Vassar-Robot-Competition-2018/teamA/notebook/IMG_0_WEEK4.JPG

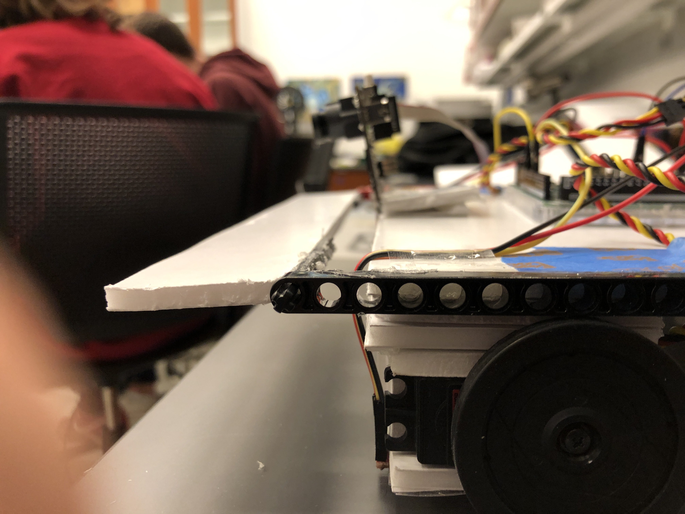
notebook/IMG_0_WEEK4.JPG
