Vassar-Robot-Competition-2018/teamA/notebook/IMG_1_WEEK4.JPG

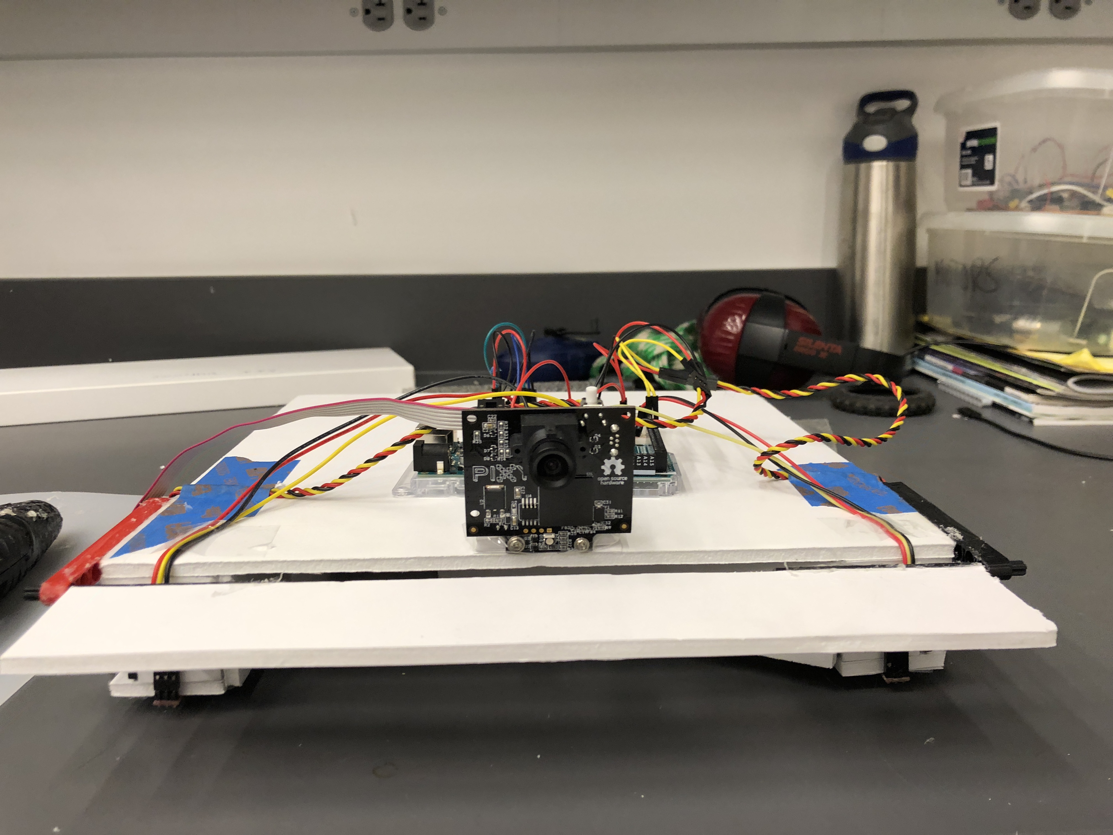
notebook/IMG_1_WEEK4.JPG
