Vassar-Robot-Competition-2018/teamA/notebook/IMG_2WEEK4.JPG

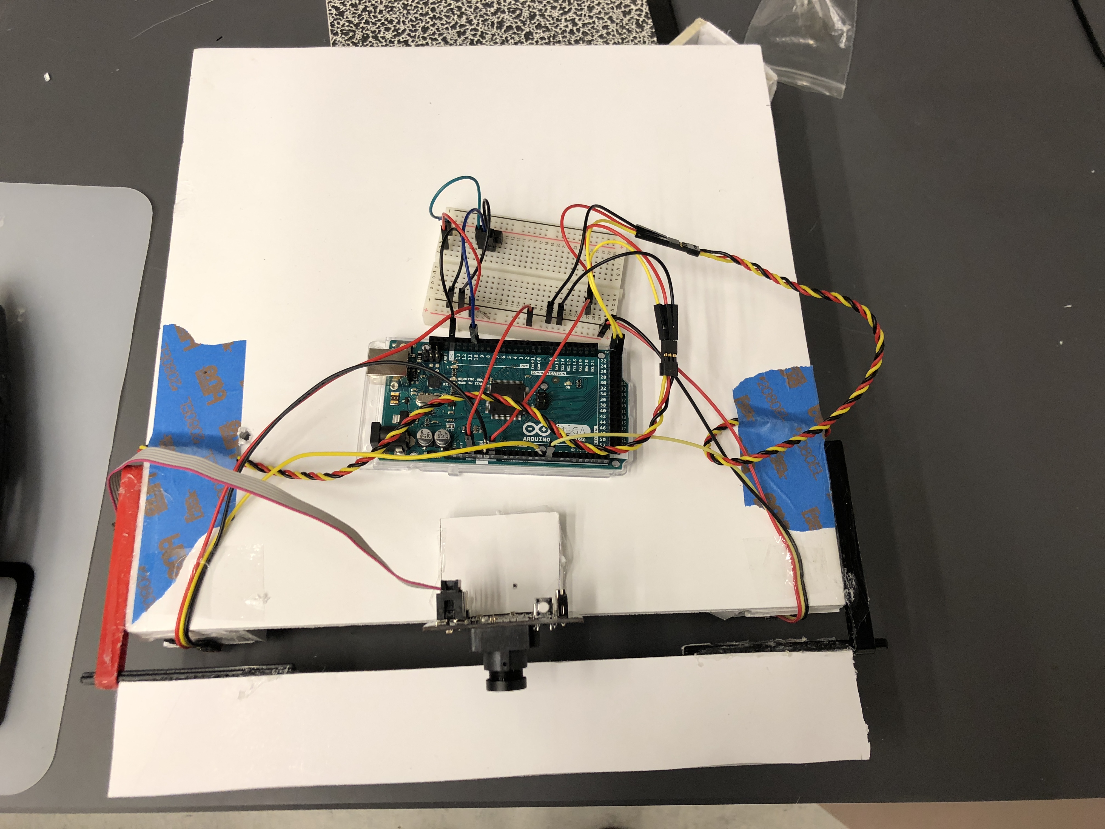
notebook/IMG_2WEEK4.JPG
