Vassar-Robot-Competition-2018/teamA/notebook/IMG_2205.jpg

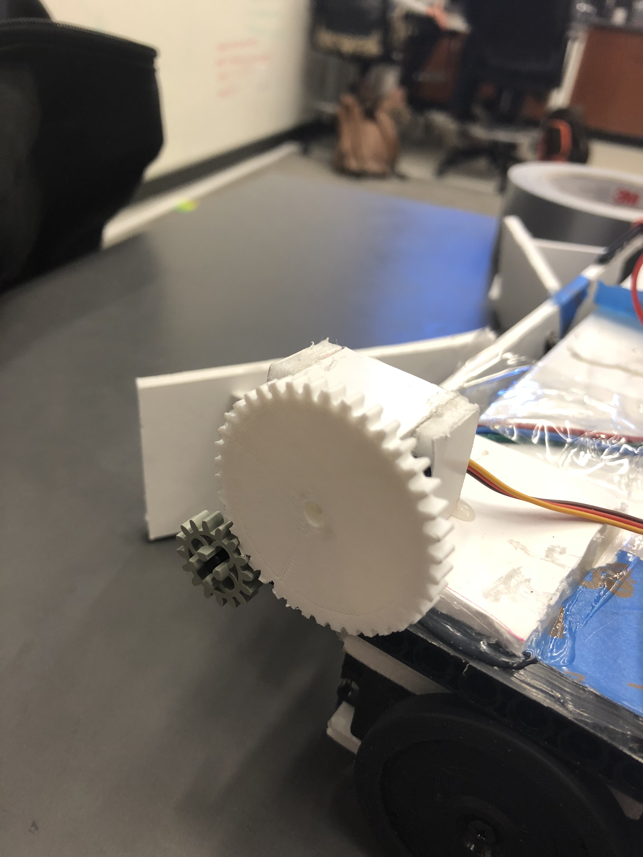
notebook/IMG_2205.jpg
