Vassar-Robot-Competition-2018/teamA/notebook/IMG_2209.jpg

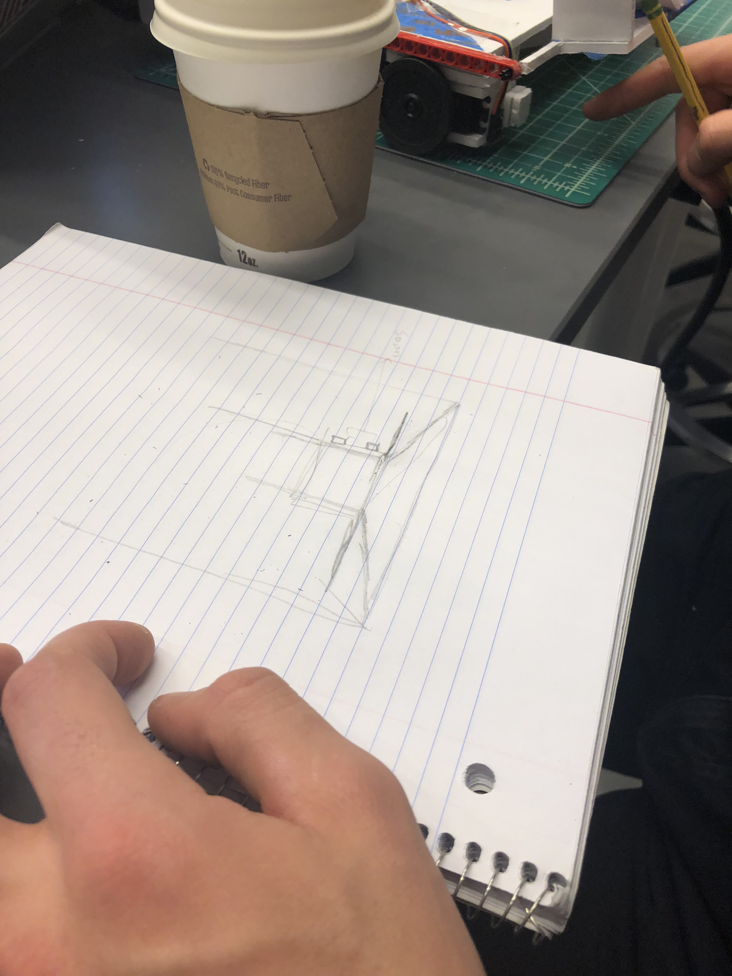
notebook/IMG_2209.jpg
