Vassar-Robot-Competition-2018/teamA/notebook/week-3-1.jpg

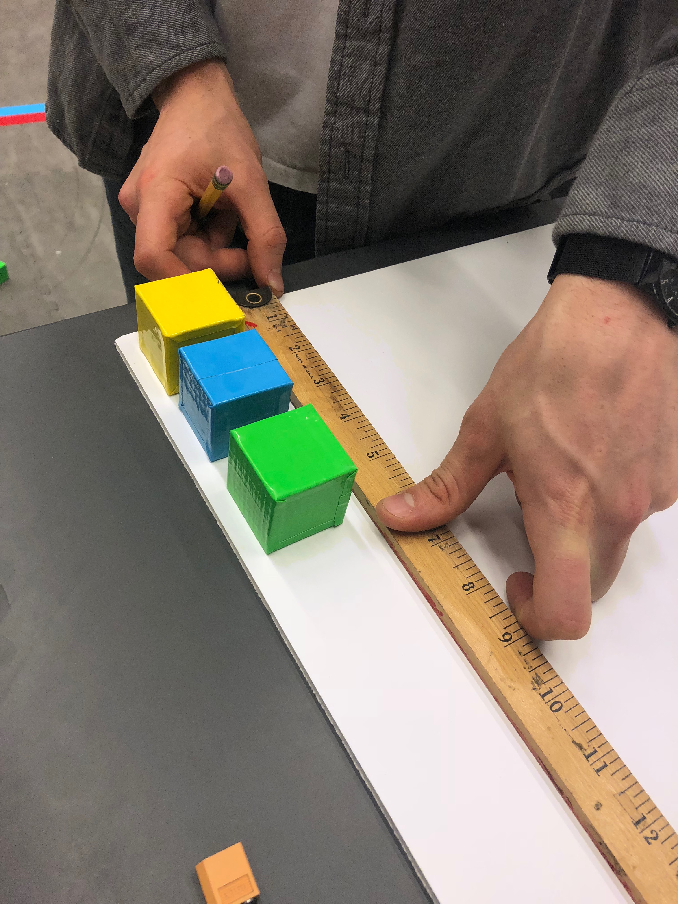
notebook/week-3-1.jpg
