Vassar-Robot-Competition-2018/teamA/notebook/week-3-3.jpg

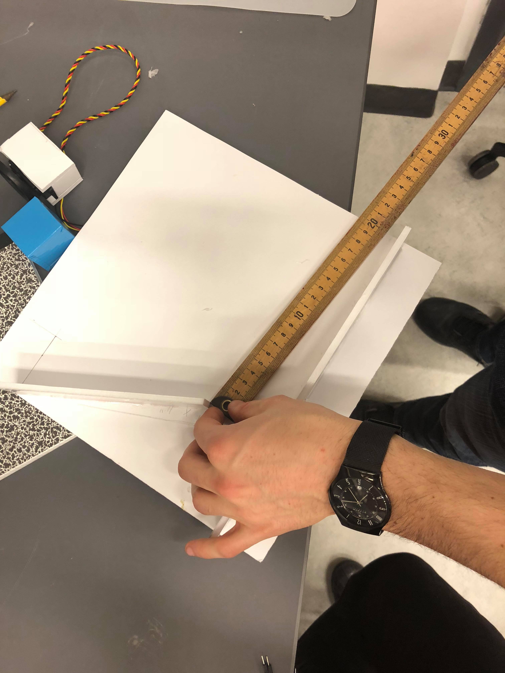
notebook/week-3-3.jpg
