Vassar-Robot-Competition-2018/teamA/notebook/week-3-5.jpg

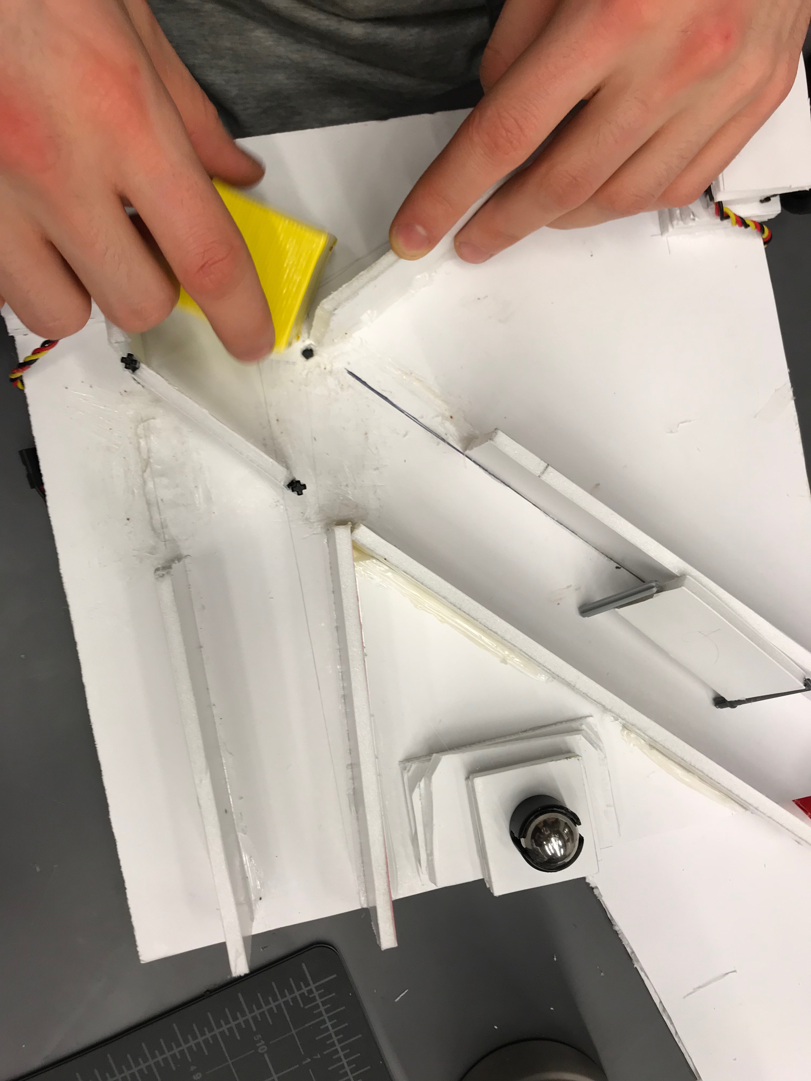
notebook/week-3-5.jpg
