Vassar-Robot-Competition-2018/teamA/notebook/week-3-6.jpg

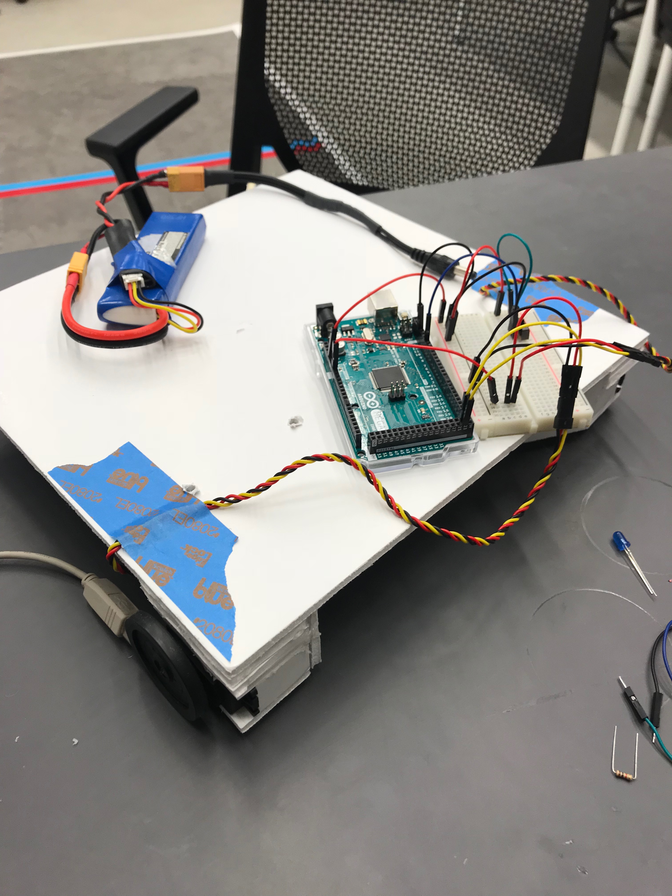
notebook/week-3-6.jpg
