Vassar-Robot-Competition-2018/teamA/notebook/week-5-image1.jpg

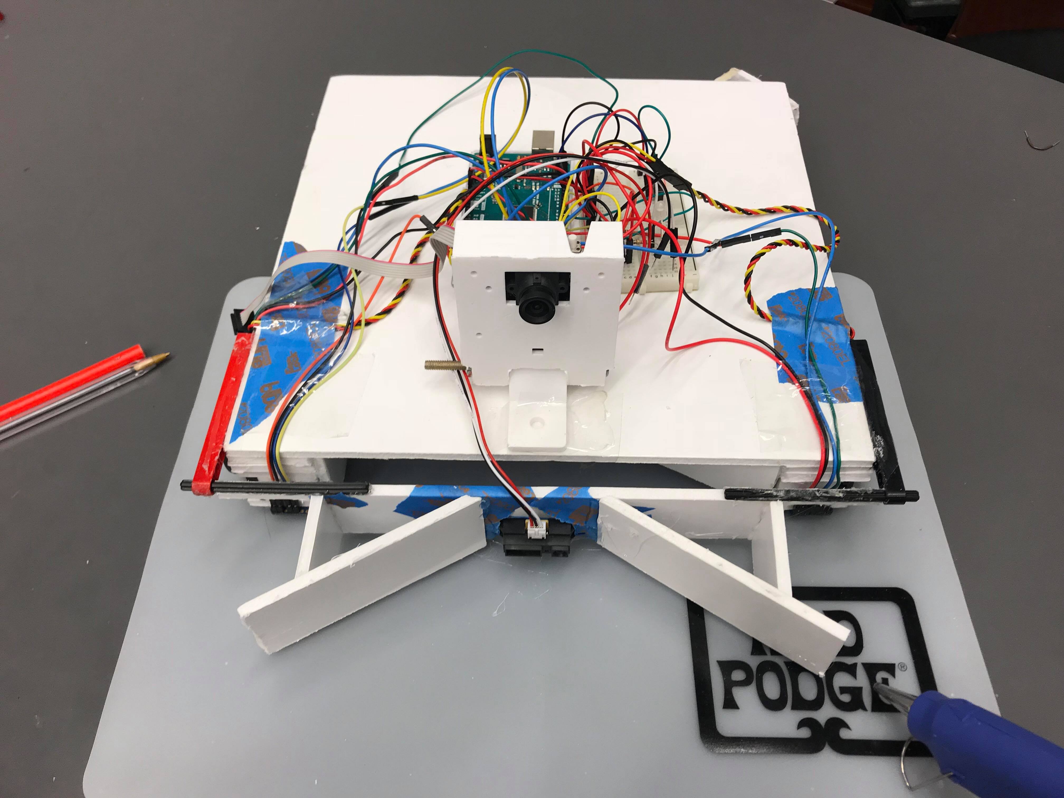
notebook/week-5-image1.jpg
