Vassar-Robot-Competition-2018/teamA/notebook/Gear Rack (3).stl

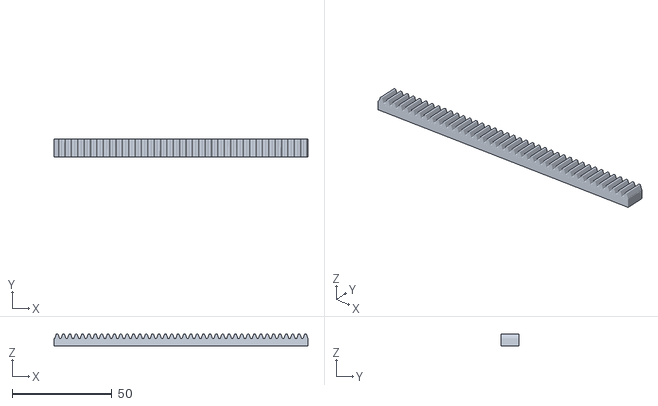
[picture p15: CAD file, 2018-04-03]
notebook/Gear Rack (3).stl
127.0 x 9.00 x 6.12
