Vassar-Robot-Competition-2018/teamA/code/code.ino

// Color sensor module which allows for multiple sensors
// https://github.com/Fire7/Adafruit_TCS34725_SoftI2C
#include <Adafruit_TCS34725softi2c.h>

// Pixy module
#include <SPI.h>
#include <Pixy.h>

// Servo module
#include <Servo.h>

int baud = 9600;

// Debug flag. Set to 1 if we want to print debug info
boolean DEBUG = 1;

// Constants
const int leftFrontServoPin = 8; // Continuous rotation servo for left front wheel
const int rightFrontServoPin = 10; // Continuous rotation servo for right front wheel
const int leftBackServoPin = 9; // Continuous rotation servo for left back wheel
const int rightBackServoPin = 11; // Continuous rotation servo for right back wheel
const int sorterMechanismServoPin = 5; // Flippy Floppy McDoodle if Bad Block
const int doorMechanismServoPin = 6; //Door says come in!! or Don't!!

int blockPresent = 0; // We start out without a block in the chamber.
int blocksCaptured = 0; // Set an int to store the number of blocks we've captured

const int COLOR_NULL = 0;
const int COLOR_RED = 1;
const int COLOR_BLUE = 2;
const int COLOR_YELLOW = 3;
const int COLOR_GREEN = 4;

int countTemp = 0;

int homeQuadrantColor = COLOR_NULL;
int currentQuadrantColor = COLOR_NULL;
int currentBlockColor = COLOR_NULL;
int lastColorLeft = COLOR_NULL;
int lastColorRight = COLOR_NULL;

// The threshold for the boundary lines
// Setting to 100 temporarily. This will also catch the in-boundary lines,
// but we'll deal with that later
int leftSensorBoundaryThreshold = 100;
int rightSensorBoundaryThreshold = 500;

/** RGB LED Pins **/

// LED for home quadrant
const int homeLEDRedPin = 4;
const int homeLEDGreenPin = 3;
const int homeLEDBluePin = 2;

// LED for current quadrant
const int quadrantLEDRedPin = 22;
const int quadrantLEDGreenPin = 23;
const int quadrantLEDBluePin = 24;

// LED for current block
const int blockLEDRedPin = 25;
const int blockLEDGreenPin = 26;
const int blockLEDBluePin = 27;

// Servos
Servo leftFrontServo;
Servo rightFrontServo;
Servo leftBackServo;
Servo rightBackServo;
Servo sorterMechanismServo;
Servo doorMechanismServo;

// Pixy camera
Pixy pixy;

// Color sensor underneith body
Adafruit_TCS34725softi2c tcsFunnel = Adafruit_TCS34725softi2c(
                                       TCS34725_INTEGRATIONTIME_24MS,
                                       TCS34725_GAIN_1X,
                                       34 /* SDA */, 35 /* SCL */);

// Ground color sensors
Adafruit_TCS34725softi2c tcsRight = Adafruit_TCS34725softi2c(
                                      TCS34725_INTEGRATIONTIME_24MS,
                                      TCS34725_GAIN_1X,
                                      30 /* SDA */, 31 /* SCL */);
Adafruit_TCS34725softi2c tcsLeft = Adafruit_TCS34725softi2c(
                                     TCS34725_INTEGRATIONTIME_24MS,
                                     TCS34725_GAIN_1X,
                                     32 /* SDA */, 33 /* SCL */);

// States
unsigned long stateStartTime;

// Spin state info
int backupTime;
int spinTime;
boolean state_spinBackup = false;
boolean state_spinSpin = false;
boolean state_spinLeft = false;

// Push state info
boolean state_push = true;

// Homing States
boolean state_wantToGoHome = false;

// Out of bound states
int LEFT_OUT = 40;
int RIGHT_OUT = 41;
int BOTH_OUT = 42;

int homeLineCount = 0;

// BLOCKS
uint16_t blocks;

void debugln(String msg) {
  if (DEBUG) {
    Serial.println(msg);
  }
}

void debug(String msg) {
  if (DEBUG) {
    Serial.print(msg);
  }
}

void debugln(long msg) {
  if (DEBUG) {
    Serial.println(msg);
  }
}

void debug(long msg) {
  if (DEBUG) {
    Serial.print(msg);
  }
}

void error(String message) {
  Serial.print("ERROR: ");
  Serial.println(message);
}

void error(long msg) {
  Serial.print("ERROR: ");
  Serial.println(msg);
}

void fail() {
  stopDriving();
  while (1); // Stop doing everything
}

void setup() {
  Serial.begin(baud);
  Serial.print("Starting...\n");

  // Initialize our continuous rotation servos
  leftFrontServo.attach(leftFrontServoPin);
  rightFrontServo.attach(rightFrontServoPin);
  leftBackServo.attach(leftBackServoPin);
  rightBackServo.attach(rightBackServoPin);

  sorterMechanismServo.attach(sorterMechanismServoPin);
  doorMechanismServo.attach(doorMechanismServoPin);

  // Initialize sorting mechanism
  setSorterClosed();
  setDoorClosed();

  // Initialize Pixy camera
  pixy.init();

  // Init all color sensors
  if (tcsLeft.begin()) {
    debugln("tcsLeft working");
  } else {
    error("Couldn't find tcsLeft");
    fail();
  }
  if (tcsRight.begin()) {
    debugln("tcsRight working");
  } else {
    error("Couldn't find tcsRight");
    fail();
  }
  if (tcsFunnel.begin()) {
    debugln("tcsFunnel working");
  } else {
    error("Couldn't find tcsFunnel");
    fail();
  }

  // Initialize LEDs
  pinMode(homeLEDRedPin, OUTPUT);
  pinMode(homeLEDGreenPin, OUTPUT);
  pinMode(homeLEDBluePin, OUTPUT);

  pinMode(quadrantLEDRedPin, OUTPUT);
  pinMode(quadrantLEDGreenPin, OUTPUT);
  pinMode(quadrantLEDBluePin, OUTPUT);

  pinMode(blockLEDRedPin, OUTPUT);
  pinMode(blockLEDGreenPin, OUTPUT);
  pinMode(blockLEDBluePin, OUTPUT);

  setLEDsFromState();

  // Set initial state
  resetAllStates();
  setStateTrue(&state_push);
}

//Code that continuously runs on Arduino
void loop() {
  // Some line padding for each loop iteration
  debugln("");
  debug("HOME LINE COUNT: "); debugln(homeLineCount);

  // Things to do every time no matter what
  uint16_t rF, bF, gF, cF, rR, gR, bR, cR, rL, gL, bL, cL;
  tcsRight.getRawData(&rR, &gR, &bR, &cR);
  tcsLeft.getRawData(&rL, &gL, &bL, &cL);
  tcsFunnel.getRawData(&rF, &gF, &bF, &cF);

  printCurrentState();

  blocks = pixy.getBlocks();

  setQuadrantColors(rR, gR, bR, cR, rL, gL, bL, cL);
  printBlockColors(rF, gF, bF, cF);

  int outOfBounds = isOutOfBounds(rL, gL, bL, cL, rR, gR, bR, cR);

  if (state_push) {
    push(outOfBounds);

    if (blockPresent && isHomeBlock(rF, gF, bF, cF)) {
      debug("THERE IS A BLOCK");
      setDoorOpen();
      delay(300);
      blocksCaptured = blocksCaptured + 1;
      debug("WE HAVE CAPTURED: ");
      debug(blocksCaptured);
      debugln(" BLOCKS");
    } else if (blockPresent) {
      setSorterOpen();
      delay(750);
    } else {
      setSorterClosed();
      setDoorClosed();
    }

  } else if (isSpinning()) {
    if (state_spinBackup) {
      spinBackup();
    } else if (state_spinSpin) {
      spin(state_spinLeft);
    } else {
      error("INVALID SPIN STATE");
      fail();
    }
  } else {
    error("INVALID STATE");
    fail();
  }
}

void printCurrentState() {
  debug("state_spinBackup: "); debugln(state_spinBackup);
  debug("state_spinSpin: "); debugln(state_spinSpin);
  debug("state_push: "); debugln(state_push);
}

boolean isHomeBlock(int signature) {
  return signature == homeQuadrantColor;
}

// Finds the biggest block and returns a pointer to it
Block* findBestBlock(Block** blocks, int len) {
  Block* result;
  int i;

  result = blocks[0];

  for (i = 1; i < len; i++) {
    if (isBlock(&pixy.blocks[i])) {
      int resultArea = result->width * result->height;
      int currentArea = pixy.blocks[i].width * pixy.blocks[i].height;
      if (resultArea < currentArea && isHomeBlock(pixy.blocks[i].signature)) {
        result = &pixy.blocks[i];
      }
    }
  }

  return result;
}

boolean isBlock(Block* block) {
  int width = block->width;
  int height = block->height;
  int x = block->x;
  int y = block->y;

  if (homeQuadrantColor != COLOR_NULL) {
    if (state_wantToGoHome) {
      return !((width >= 0.9 * height) && (width <= 1.4 * height));
    } else {
      return (width >= 0.9 * height) && (width <= 1.4 * height);
    }
  } else {
    return false;    
  }
}

bool isSpinning() {
  return state_spinSpin || state_spinBackup;
}

// Returns true if the robot is inside the boundary lines, false otherwise
int isOutOfBounds(uint16_t rL, uint16_t gL, uint16_t bL, uint16_t cL,
                  uint16_t rR, uint16_t gR, uint16_t bR, uint16_t cR) {
  boolean leftOutOfBounds = cL > 1200;
  boolean rightOutOfBounds = cR > 1200;

  //  debug("cL: "); debug(cL); debug("; cR: "); debugln(cR);

  if (homeQuadrantColor == COLOR_NULL || wantToGoHome()) {
    homeLineCount = 0;
    // Only white lines make it out of bounds
    if (leftOutOfBounds && rightOutOfBounds) {
      return BOTH_OUT;
    } else if (leftOutOfBounds) {
      return LEFT_OUT;
    } else if (rightOutOfBounds) {
      return RIGHT_OUT;
    } else {
      return 0;
    }
  } else {
    // White lines and home quadrant lines are out of bounds
    boolean leftOutHomeBounds = 0;
    boolean rightOutHomeBounds = 0;
    // Serial.print("TEST");
    countTemp = countTemp + 1;

    if (countTemp > 50) {
      if (homeQuadrantColor == COLOR_BLUE) {
        leftOutHomeBounds = isBlueLineLeft(rL, gL, bL, cL);
        rightOutHomeBounds = isBlueLineRight(rR, gR, bR, cR);

      } else if (homeQuadrantColor == COLOR_RED) {
        leftOutHomeBounds = isRedLineLeft(rL, gL, bL, cL);
        rightOutHomeBounds = isRedLineRight(rR, gR, bR, cR);

      } else if (homeQuadrantColor == COLOR_YELLOW) {
        leftOutHomeBounds = isYellowLineLeft(rL, gL, bL, cL);
        rightOutHomeBounds = isYellowLineRight(rR, gR, bR, cR);

      } else if (homeQuadrantColor == COLOR_GREEN) {
        leftOutHomeBounds = isGreenLineLeft(rL, gL, bL, cL);
        rightOutHomeBounds = isGreenLineRight(rR, gR, bR, cR);
      }
    }

    if (leftOutHomeBounds || rightOutHomeBounds) {
      homeLineCount = 1;
    }

    if ((leftOutOfBounds && rightOutOfBounds) ||
        (leftOutHomeBounds || rightOutHomeBounds)) {
      return BOTH_OUT;
    } else if (leftOutOfBounds || leftOutHomeBounds) {
      return LEFT_OUT;
    } else if (rightOutOfBounds || rightOutHomeBounds) {
      return RIGHT_OUT;
    } else {
      return 0;
    }
  }
}


// Set the home color and last seen left and right wheel colors
void setQuadrantColors(uint16_t rL, uint16_t gL, uint16_t bL, uint16_t cL,
                       uint16_t rR, uint16_t gR, uint16_t bR, uint16_t cR) {
  // Set home color if we haven't already
  if (homeQuadrantColor == COLOR_NULL) {
    if (isYellowLineLeft(rL, gL, bL, cL) || isYellowLineRight(rR, gR, bR, cR)) {
      setHomeQuadrant(COLOR_YELLOW);
    } else if (isRedLineLeft(rL, gL, bL, cL) || isRedLineRight(rR, gR, bR, cR)) {
      setHomeQuadrant(COLOR_RED);
    } else if (isBlueLineLeft(rL, gL, bL, cL) || isBlueLineRight(rR, gR, bR, cR)) {
      setHomeQuadrant(COLOR_BLUE);
    } else if (isGreenLineLeft(rL, gL, bL, cL) || isGreenLineRight(rR, gR, bR, cR)) {
      setHomeQuadrant(COLOR_GREEN);
    }
  }

  // Set the last color seen for left wheel
  if (isYellowLineLeft(rL, gL, bL, cL)) {
    lastColorLeft = COLOR_YELLOW;
  } else if (isGreenLineLeft(rL, gL, bL, cL)) {
    lastColorLeft = COLOR_GREEN;
  } else if (isBlueLineLeft(rL, gL, bL, cL)) {
    lastColorLeft = COLOR_BLUE;
  } else if (isRedLineLeft(rL, gL, bL, cL)) {
    lastColorLeft = COLOR_RED;
  }

  // Set last color seen for right wheel
  if (isYellowLineRight(rR, gR, bR, cR)) {
    lastColorRight = COLOR_YELLOW;
  } else if (isGreenLineRight(rR, gR, bR, cR)) {
    lastColorRight = COLOR_GREEN;
  } else if (isBlueLineRight(rR, gR, bR, cR)) {
    lastColorRight = COLOR_BLUE;
  } else if (isRedLineRight(rR, gR, bR, cR)) {
    lastColorRight = COLOR_RED;
  }

  if (lastColorLeft == lastColorRight && currentQuadrantColor != lastColorRight) {
    setCurrentQuadrant(lastColorLeft);
  }
}

void printBlockColors(uint16_t rF, uint16_t gF, uint16_t bF, uint16_t cF) {
  if (isYellowBlock(rF, gF, bF, cF)) {
    setCurrentBlock(COLOR_YELLOW);
  } else if (isRedBlock(rF, gF, bF, cF)) {
    setCurrentBlock(COLOR_RED);
  } else if (isBlueBlock(rF, gF, bF, cF)) {
    setCurrentBlock(COLOR_BLUE);
  } else if (isGreenBlock(rF, gF, bF, cF)) {
    setCurrentBlock(COLOR_GREEN);
  } else {
    setCurrentBlock(COLOR_NULL);
  }
}

/** State Setters **/

void setHomeQuadrant(int color) {
  homeQuadrantColor = color;
  debug("Home Quadrant Color: ");
  switch (color) {
    case COLOR_NULL:
      debugln("NULL");
      setRGBLed(homeLEDRedPin, homeLEDGreenPin, homeLEDBluePin, 0, 0, 0);
      break;
    case COLOR_RED:
      debugln("RED");
      setRGBLed(homeLEDRedPin, homeLEDGreenPin, homeLEDBluePin, 255, 0, 0);
      break;
    case COLOR_GREEN:
      debugln("GREEN");
      setRGBLed(homeLEDRedPin, homeLEDGreenPin, homeLEDBluePin, 0, 255, 0);
      break;
    case COLOR_BLUE:
      debugln("BLUE");
      setRGBLed(homeLEDRedPin, homeLEDGreenPin, homeLEDBluePin, 0, 0, 255);
      break;
    case COLOR_YELLOW:
      debugln("YELLOW");
      setRGBLed(homeLEDRedPin, homeLEDGreenPin, homeLEDBluePin, 255, 255, 0);
      break;
    default:
      error("Invalid home quadrant color");
      error(color);
      fail();
  }
}

void setCurrentQuadrant(int color) {
  currentQuadrantColor = color;
  debug("Current Quadrant Color: ");
  switch (color) {
    case COLOR_NULL:
      debugln("NULL");
      setRGBLed(quadrantLEDRedPin, quadrantLEDGreenPin, quadrantLEDBluePin, 0, 0, 0);
      break;
    case COLOR_RED:
      debugln("RED");
      setRGBLed(quadrantLEDRedPin, quadrantLEDGreenPin, quadrantLEDBluePin, 255, 0, 0);
      break;
    case COLOR_GREEN:
      debugln("GREEN");
      setRGBLed(quadrantLEDRedPin, quadrantLEDGreenPin, quadrantLEDBluePin, 0, 255, 0);
      break;
    case COLOR_BLUE:
      debugln("BLUE");
      setRGBLed(quadrantLEDRedPin, quadrantLEDGreenPin, quadrantLEDBluePin, 0, 0, 255);
      break;
    case COLOR_YELLOW:
      debugln("YELLOW");
      setRGBLed(quadrantLEDRedPin, quadrantLEDGreenPin, quadrantLEDBluePin, 255, 255, 0);
      break;
    default:
      error("Invalid current quadrant color");
      error(color);
      fail();
  }
}

void setCurrentBlock(int color) {
  currentBlockColor = color;
  debug("Block Color: ");
  switch (color) {
    case COLOR_NULL:
      debugln("NULL");
      setRGBLed(blockLEDRedPin, blockLEDGreenPin, blockLEDBluePin, 0, 0, 0);
      blockPresent = 0;
      break;
    case COLOR_RED:
      debugln("RED");
      setRGBLed(blockLEDRedPin, blockLEDGreenPin, blockLEDBluePin, 255, 0, 0);
      blockPresent = 1;
      break;
    case COLOR_GREEN:
      debugln("GREEN");
      setRGBLed(blockLEDRedPin, blockLEDGreenPin, blockLEDBluePin, 0, 255, 0);
      blockPresent = 1;
      break;
    case COLOR_BLUE:
      debugln("BLUE");
      setRGBLed(blockLEDRedPin, blockLEDGreenPin, blockLEDBluePin, 0, 0, 255);
      blockPresent = 1;
      break;
    case COLOR_YELLOW:
      debugln("YELLOW");
      setRGBLed(blockLEDRedPin, blockLEDGreenPin, blockLEDBluePin, 255, 255, 0);
      blockPresent = 1;
      break;
    default:
      error("Invalid color");
      error(color);
      fail();
  }
}

/** Color detection **/

boolean isRedBlock(uint16_t r, uint16_t g, uint16_t b, uint16_t c) {
  if (r > g && r > b && c > 200) {
    debugln("RED!");
    return true;
  } else {
    //    Serial.println("NOT RED!");
    return false;
  }
}

boolean isRedLineLeft(uint16_t r, uint16_t g, uint16_t b, uint16_t c) {
  return isRedBlock(r, g, b, c) && c < 1500;
}

boolean isRedLineRight(uint16_t r, uint16_t g, uint16_t b, uint16_t c) {
  return isRedBlock(r, g, b, c) && c < 1500;
}

boolean isBlueBlock(uint16_t r, uint16_t g, uint16_t b, uint16_t c) {
  // blue is greatest
  // red is least
  return b > g && g > r && c > 400;
}

boolean isBlueLineLeft(uint16_t r, uint16_t g, uint16_t b, uint16_t c) {
  return isBlueBlock(r, g, b, c) && c < 1500;
}

boolean isBlueLineRight(uint16_t r, uint16_t g, uint16_t b, uint16_t c) {
  return isBlueBlock(r, g, b, c) && c < 1500;
}

boolean isYellowBlock(uint16_t r, uint16_t g, uint16_t b, uint16_t c) {
  return r > b && g > b && c > 400
         && abs(r - g) <= 400
         && (b - 100) * 2 <= r
         && (b - 100) * 2 <= g;
}

boolean isYellowLineLeft(uint16_t r, uint16_t g, uint16_t b, uint16_t c) {
  return isYellowBlock(r, g, b, c) && c < 1500;
}

boolean isYellowLineRight(uint16_t r, uint16_t g, uint16_t b, uint16_t c) {
  return isYellowBlock(r, g, b, c) && c < 1500;
}

boolean isGreenBlock(uint16_t r, uint16_t g, uint16_t b, uint16_t c) {
  return g > b && g > r && c > 400 && g > (r + 75) && g > (b + 75);
}

boolean isGreenLineLeft(uint16_t r, uint16_t g, uint16_t b, uint16_t c) {
  return isGreenBlock(r, g, b, c);
}

boolean isGreenLineRight(uint16_t r, uint16_t g, uint16_t b, uint16_t c) {
  return isGreenBlock(r, g, b, c);
}

// Returns true if the given block colors are the same as the home
// quadrant color
boolean isHomeBlock(uint16_t r, uint16_t g, uint16_t b, uint16_t c) {
  if (homeQuadrantColor == COLOR_NULL) {
    debug("Home color has not been set");
    return 0;
  } else if (homeQuadrantColor == COLOR_YELLOW && isYellowBlock(r, g, b, c)) {
    return 1;
  } else if (homeQuadrantColor == COLOR_BLUE && isBlueBlock(r, g, b, c)) {
    return 1;
  } else if (homeQuadrantColor == COLOR_GREEN && isGreenBlock(r, g, b, c)) {
    return 1;
  } else if (homeQuadrantColor == COLOR_RED && isRedBlock(r, g, b, c)) {
    return 1;
  } else {
    // Input block is not a color
    return 0;
  }
}

// Drive the robot forward at a constant speed
void drive() {
  setSpeed(100);
}

// Stop the robot from driving
void stopDriving() {
  setSpeed(0);
}

// Backup
void backup() {
  setSpeed(-100);
}

// Start the robot spinning
void startSpinning(int t) {
  //  setFrontFlapDown();
  spinTime = t;
  if (random(0, 100) > 50) {
    spin(true);
    Serial.println("SPIN LEFT");
  } else {
    spin(false);
    Serial.println("SPIN RIGHT");
  }
}

// Continue spinning right
void spin(boolean spinLeft) {
  if (!state_spinSpin) {
    resetAllStates();
    setStateTrue(&state_spinSpin);
    state_spinLeft = spinLeft;
  }
  int timeLeft = spinTime - (millis() - stateStartTime);
  debugln("SPINNING!");
  debug(millis());
  debug(" ");
  debugln(stateStartTime);
  debug("TIME LEFT: ");
  debugln(timeLeft);
  Block* bestBlock;

  if (blocks) {
    bestBlock = findBestBlock(&pixy.blocks, blocks);
  }

  if (timeLeft <= 0 || isHomeBlock(bestBlock->signature)) {
    resetAllStates();
    setStateTrue(&state_push);
    return;
  }
  if (state_spinLeft) {
    setSpeed(-100, 100);
  } else {
    setSpeed(100, -100);
  }
}

void startSpinBackup(int t) {
  //  setFrontFlapUp();
  backupTime = t;
  spinBackup();
}

void spinBackup() {
  if (!state_spinBackup) {
    resetAllStates();
    setStateTrue(&state_spinBackup);
  }
  int timeLeft = backupTime - (millis() - stateStartTime);
  debug("TIME LEFT: ");
  debugln(timeLeft);
  if (timeLeft <= 0) {
    startSpinning(randomInt(1500, 2500));
    return;
  }
  setSpeed(-100);
}

boolean wantToGoHome() {
  if (millis() >= 3 * 60000 /* 3 minute */) {
    state_wantToGoHome = true;
    return true;
  } else {
    return false;
  }
}

void push(int outOfBounds) {
  if (!state_push) {
    resetAllStates();
    setStateTrue(&state_push);
  }

  if (millis() - stateStartTime > 45000 /* 45 seconds */) {
    setSpeed(0);
    delay(200);
    setSpeed(-100);
    delay(500);
    setSpeed(-100,100);
    delay(2000);
    setSpeed(100);
    stateStartTime = millis();
  }

  // Done
  if (currentQuadrantColor == homeQuadrantColor && wantToGoHome()) {
    state_wantToGoHome = false;
    setSpeed(100);
    delay(1000);
    fail();
  }

  if (!outOfBounds) {
    setSpeed(100);
//    followBlocks(); // Uses Pixy
  } else if (homeLineCount) {
    setSpeed(0);
    delay(200);
    setSpeed(-100);
    delay(500);
    setSpeed(-100, 100);
    delay(2500);
    homeLineCount = 0;
    setCurrentQuadrant(COLOR_NULL);
  } else {
    setSpeed(0);
    delay(200);
    startSpinBackup(1200);
  }
}

// Follow blocks based on information from the Pixy camera
void followBlocks() {
  int j;
  int x;
  float leftSpeed;
  float rightSpeed;

  if (blocks) {
    Block* block = findBestBlock(&pixy.blocks, blocks);
    if (isHomeBlock(block->signature)) {
      // block->print();
      // center is 160
      x = block->x - 160;
      debugln(x);
      if (x >= 0) {
        leftSpeed = min(100, 100 - 100 * (sqrt(x) / -sqrt(160.0)));
        rightSpeed = min(100, 100 - 100 * (sqrt(x) / sqrt(160.0)));
      } else {
        leftSpeed = min(100, 100 - 100 * (-sqrt(-x) / -sqrt(160.0)));
        rightSpeed = min(100, 100 - 100 * (-sqrt(-x) / sqrt(160.0)));
      }
      //    debug("X: "); debugln(x);
      //    debug("L Speed: "); debugln(leftSpeed);
      //    debug("R Speed: "); debugln(rightSpeed);
      //    debugln();
      setSpeed(leftSpeed, rightSpeed);
    } else {
      debugln("No home blocks in frame");
      setSpeed(100);
    }
  } else {
    debugln("No blocks");
    setSpeed(100);
  }
}

int randomInt(int min, int max) {
  return min + rand() % (max + 1 - min);
}

void setLEDsFromState() {
  setHomeQuadrant(homeQuadrantColor);
  setCurrentBlock(currentBlockColor);
  setCurrentQuadrant(currentQuadrantColor);
}

void setRGBLed(int redPin, int greenPin, int bluePin,
               uint16_t r, uint16_t g, uint16_t b) {
  // If you are using a common *ANODE LED* instead of common
  // CATHODE, connect the long pin to +5 instead of ground
  // We are using ANODE, invert the color values
  int red = 255 - r;
  int green = 255 - g;
  int blue = 255 - b;
  analogWrite(redPin, red);
  analogWrite(greenPin, green);
  analogWrite(bluePin, blue);
}

void setSpeed(int speed) {
  setLeftSpeed(speed);
  setRightSpeed(speed);
}

void setSpeed(int left, int right) {
  setLeftSpeed(left);
  setRightSpeed(right);
}

int speedToDegrees(int speed) {
  int deg = (speed * 0.6) + 90;
  return deg;
}

// Reverse full speed -100, Forward full speed 100
void setLeftSpeed(int speed) {
  int degrees = 180 - speedToDegrees(speed) + 3;
  //  debug("Left Degrees: "); debugln(degrees);
  leftFrontServo.write(degrees);
  leftBackServo.write(degrees);
}

// Reverse full speed -100, Forward full speed 100
void setRightSpeed(int speed) {
  int degrees = speedToDegrees(speed) + 3;
  //  debug("Right Degrees: "); debugln(degrees);
  rightFrontServo.write(degrees);
  rightBackServo.write(degrees);
}

void setStateTrue(boolean *state) {
  *state = true;
  stateStartTime = millis();
}

void resetAllStates() {
  state_spinBackup = false;
  state_spinSpin = false;
  state_push = false;
}

void setSorterClosed() {
  sorterMechanismServo.write(175);
}

void setSorterOpen() {
  sorterMechanismServo.write(0);
}

void setDoorClosed() {
  doorMechanismServo.write(0);
}

void setDoorOpen() {
  doorMechanismServo.write(180);
}
