Vassar-Robot-Competition-2018/teamA/(commit log)

2018-01-30 added right motor
2018-03-03 Roam using color sensors
2018-03-04 Add state timers
2018-03-05 Change backup & reverse state
    [code.ino]
2018-03-05 Add IR pin
2018-05-13 Comment out block following with camera
2018-05-13 Improve calibration for lines
2018-05-13 Add code to display colors on LEDs
2018-05-13 Added logic for keeping track of how many blocks we have captured
2018-05-14 Add more accurate color calibrations
